Fluffster65/BattGuard/board/BattGuard/BattGuard.step

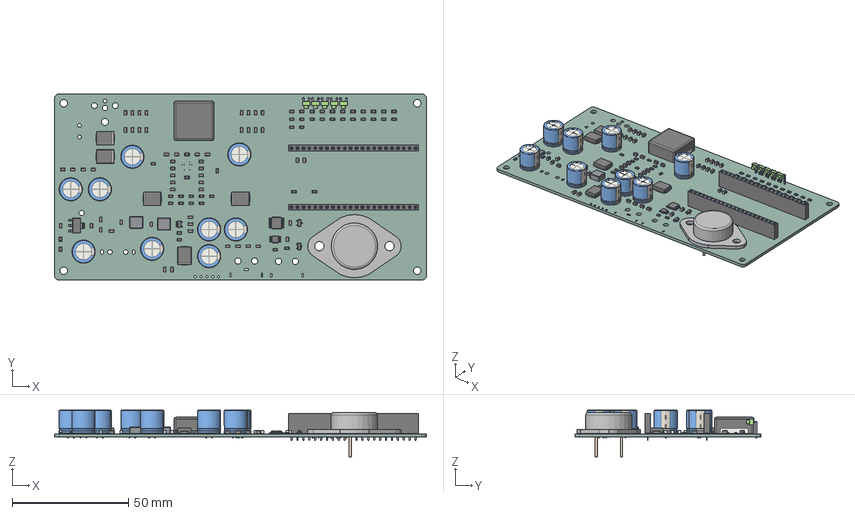
[picture p1: CAD file, 2026-10-19]
board/BattGuard/BattGuard.step
160.0 x 80.0 x 20.0 mm
PinSocket_1x22_P2.54mm_Vertical x 2
C_0805_2012Metric x 49
R_0805_2012Metric x 50
CP_Radial_D100mm_P250mm x 9
D_SMC x 5
TSSOP-10_3x3mm_P0.5mm
LED_D1.8mm_W1.8mm_H2.4mm_Horizontal_O1.27mm_Z4.9mm x 5
SOT-23 x 2
L_Bourns_SRP5030T x 2
SOT-23-5
SOT-223
L_Vishay_IHLP-6767
TSSOP-14_4.4x5mm_P0.65mm
TO-3
Bat6220_PCB
