Fluffster65/BattGuard/board/BattGuard/ESP32-Devboard.step

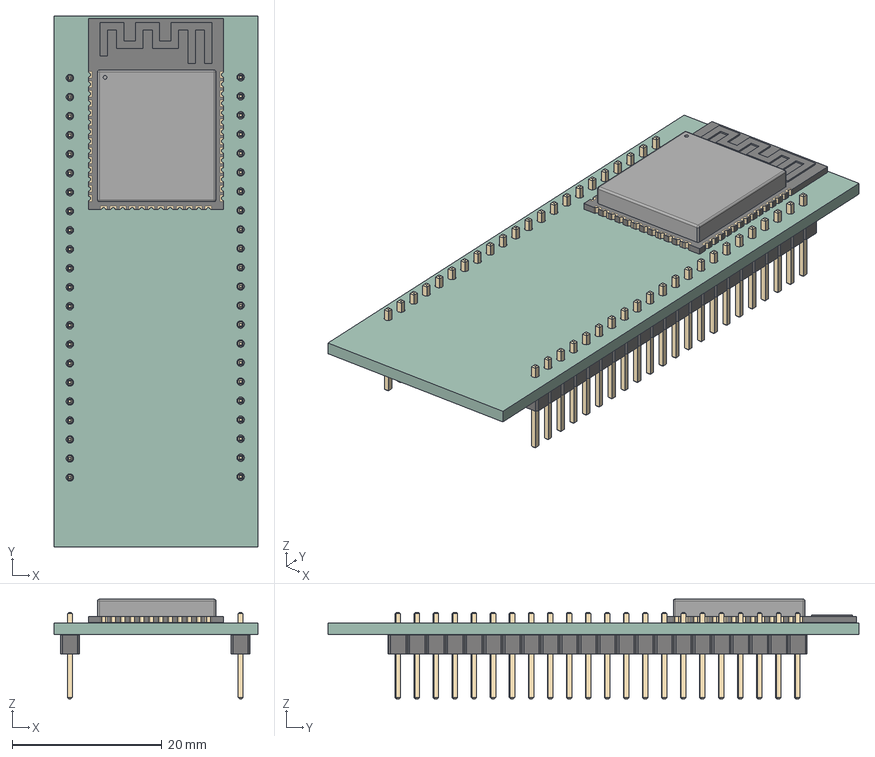
[picture p2: CAD file, 2026-10-19]
board/BattGuard/ESP32-Devboard.step
27.2 x 70.9 x 13.3 mm
ESP32-S3-WROOM-2
PinHeader_1x22_P254mm_Vertical x 2
ESPB6C6_PCB
