Fluffster65/BattGuard/board/BattGuard/BattGuard.kicad_pcb

## KiCad design board/BattGuard/BattGuard.kicad_pcb (2026-11-06)

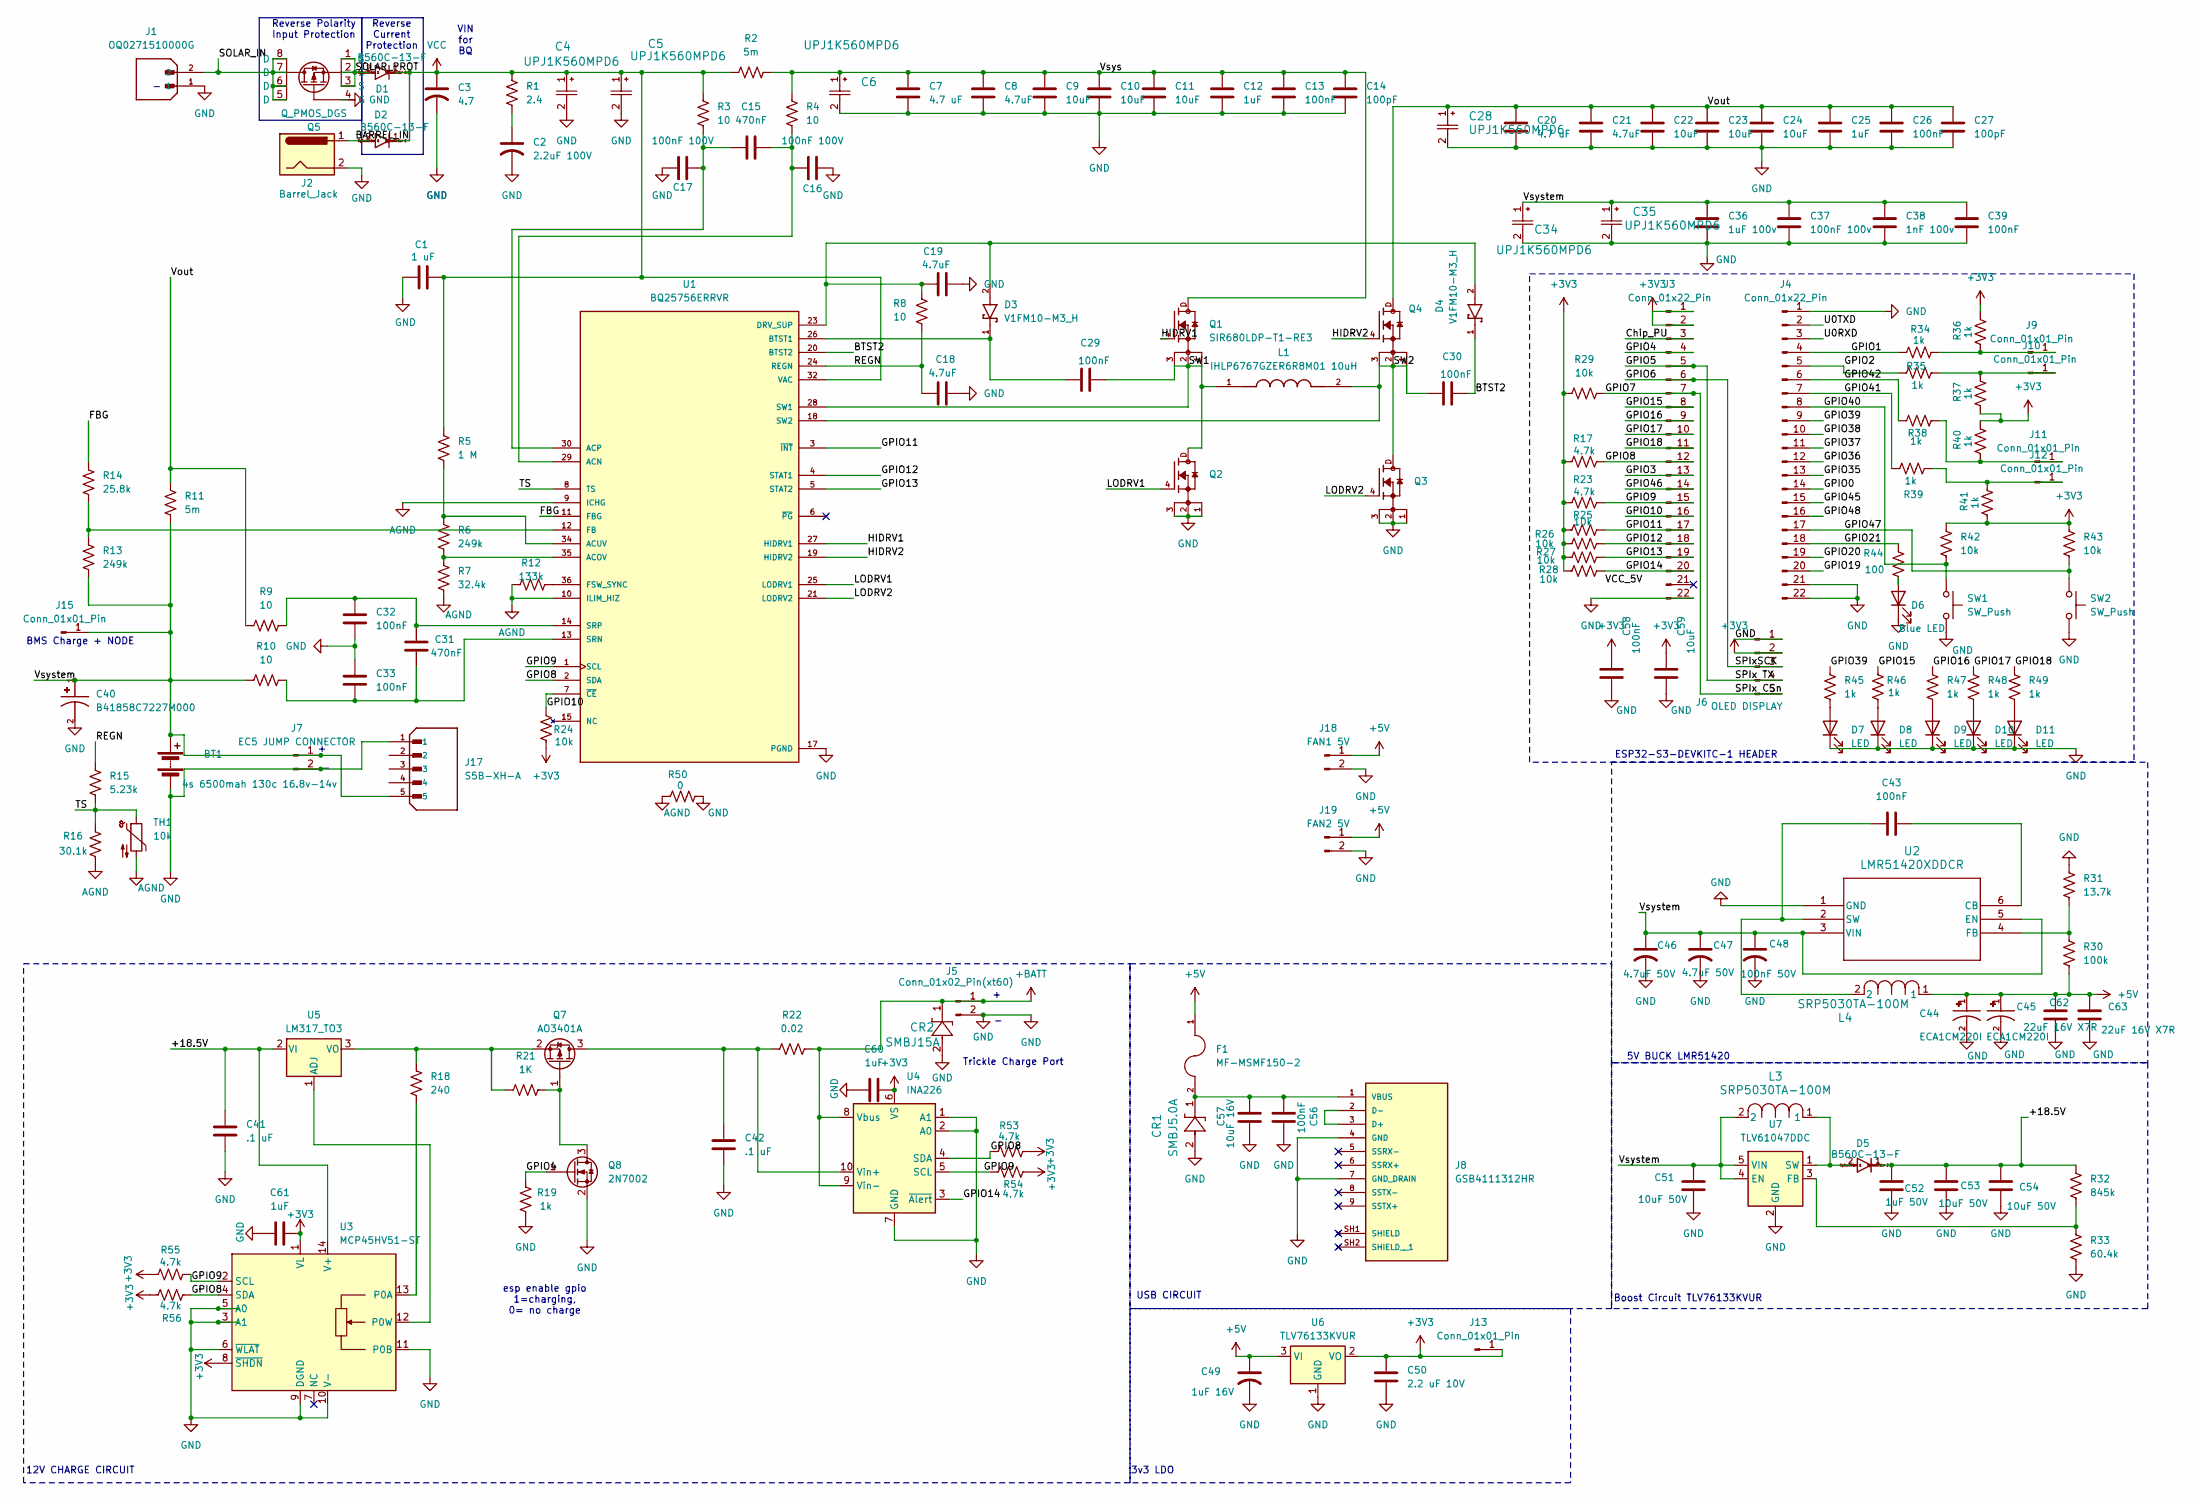
[picture p3: schematic BattGuard.kicad_sch]

Parts:
BT1: 4s 6500mah 130c 16.8v-14v
C1: 1 uF; C_0805_2012Metric
C2: 2.2uF 100V; C_1206_3216Metric
C3: 4.7; C_1210_3225Metric_Pad1.33x2.70mm_HandSolder
C4, C5, C6, C28, C34, C35: UPJ1K560MPD6; CAP_UPJ_10X15_NCH
C7, C20: 4.7 uF; C_0805_2012Metric
C8, C18, C19, C21: 4.7uF; C_0805_2012Metric
C9, C10, C11: 10uF; C_1210_3225Metric_Pad1.33x2.70mm_HandSolder
C12, C25, C60, C61: 1uF; C_0805_2012Metric
C13, C26, C29, C30, C32, C33, C39, C43, C56, C58: 100nF; C_0805_2012Metric
C14, C27: 100pF; C_0805_2012Metric
C15, C31: 470nF; C_0805_2012Metric
C16, C17: 100nF 100V; C_0805_2012Metric
C22, C23, C24, C59: 10uF; C_0805_2012Metric
C36: 1uF 100v; C_0805_2012Metric
C37: 100nF 100v; C_0805_2012Metric
C38: 1nF 100v; C_0805_2012Metric
C40: B41858C7227M000; CP_Radial_D10.0mm_P2.50mm; PARTREV 2018-10
C41, C42: .1 uF; C_0805_2012Metric
C44, C45: ECA1CM220I; CP_Radial_D10.0mm_P2.50mm; PARTREV 20-DEC-19
C46, C47: 4.7uF 50V; C_0805_2012Metric
C48: 100nF 50V; C_0805_2012Metric
C49: 1uF 16V; C_0805_2012Metric
C50: 2.2 uF 10V; C_0805_2012Metric
C51, C53, C54: 10uF 50V; C_1206_3216Metric_Pad1.33x1.80mm_HandSolder
C52: 1uF 50V; C_0805_2012Metric
C57: 10uF 16V; C_0805_2012Metric
C62, C63: 22uF 16V X7R; C_1206_3216Metric_Pad1.33x1.80mm_HandSolder
CR1: SMBJ5.0A; DO-214AASMB_J-BEND_LTF
CR2: SMBJ15A; DO-214AASMB_J-BEND_LTF
D1, D2, D5: B560C-13-F; D_SMC
D3, D4: V1FM10-M3_H; DIO_V1FM10-M3_H; PARTREV 13-May-2020; DigiKey_Part_Number 112-V1FM10-M3/HCT-ND
D6: Blue LED; LED_D1.8mm_W3.3mm_H2.4mm
D7, D8, D9, D10, D11: LED; LED_D1.8mm_W3.3mm_H2.4mm
F1: MF-MSMF150-2; FUSER_MF-MSMF150-2
J1: OQ0271510000G; PhoenixContact_GMSTBA_2,5_2-G_1x02_P7.50mm_Horizontal; PARTREV J
J2: Barrel_Jack; BarrelJack_CUI_PJ-063AH_Horizontal_CircularHoles
J3, J4: Conn_01x22_Pin; PinSocket_1x22_P2.54mm_Vertical
J5: Conn_01x02_Pin(xt60); AMASS_XT60PW-M_1x02_P7.20mm_Horizontal
J6: OLED DISPLAY; PinHeader_1x05_P2.54mm_Vertical
J7: EC5 JUMP CONNECTOR; AMASS_XT60PW-M_1x02_P7.20mm_Horizontal
J8: GSB4111312HR; USBA_receptacle; PARTREV B
J9, J10, J11, J12, J13: Conn_01x01_Pin; TestPoint_Pad_1.0x1.0mm
J15: Conn_01x01_Pin; MountingHole_2.2mm_M2_DIN965_Pad
J17: S5B-XH-A; JST_S5B-XH-A; PARTREV 27-1-20
J18: FAN1 5V; Wire_Pads_1x02_SMD_2.54
J19: FAN2 5V; Wire_Pads_1x02_SMD_2.54
L1: IHLP6767GZER6R8M01 10uH; L_Vishay_IHLP-6767; PARTREV 24-Nov-2023; DigiKey_Part_Number 541-1257-1-ND
L3, L4: SRP5030TA-100M; L_Bourns_SRP5030T
Q1, Q2, Q3, Q4: SIR680LDP-T1-RE3; TRANS_SIR680LDP-T1-RE3; PARTREV C
Q5: Q_PMOS_DGS; SOIC127P600X175-8N
Q7: AO3401A; SOT-23
Q8: 2N7002; SOT-23
R1: 2.4; R_0805_2012Metric
R2, R11: 5m; R_0805_2012Metric
R3, R4, R8, R9, R10: 10; R_0805_2012Metric
R5: 1 M; R_0805_2012Metric
R6, R13: 249k; R_0805_2012Metric
R7: 32.4k; R_0805_2012Metric
R12: 133k; R_0805_2012Metric
R14: 25.8k; R_0805_2012Metric
R15: 5.23k; R_0805_2012Metric
R16: 30.1k; R_0805_2012Metric
R17, R23, R53, R54, R55, R56: 4.7k; R_0805_2012Metric
R18: 240; R_0805_2012Metric
R19, R34, R35, R36, R37, R38, R39, R40, R41, R45, R46, R47, R48, R49: 1k; R_0805_2012Metric
R21: 1K; R_0805_2012Metric
R22: 0.02; R_0805_2012Metric
R24, R25, R26, R27, R28, R29, R42, R43: 10k; R_0805_2012Metric
R30: 100k; R_0805_2012Metric
R31: 13.7k; R_0805_2012Metric
R32: 845k; R_0805_2012Metric
R33: 60.4k; R_0805_2012Metric
R44: 100; R_0805_2012Metric
R50: 0; R_0805_2012Metric
SW1, SW2: SW_Push; Wire_Pads_1x02_SMD_2.54
TH1: 10k; R_0805_2012Metric
U1: BQ25756ERRVR; IC_BQ25756ERRVR; PARTREV November 2023; DigiKey_Part_Number 296-BQ25756ERRVRCT-ND
U2: LMR51420XDDCR; SOT23_DDC_TEX
U3: MCP45HV51-ST; TSSOP-14_4.4x5mm_P0.65mm
U4: INA226; TSSOP-10_3x3mm_P0.5mm
U5: LM317_TO3; TO-3
U6: TLV76133KVUR; SOT-223-3_TabPin2
U7: TLV61047DDC; SOT-23-5

Connections:
+5V: C44.1, C45.1, C49.1, C62.1, C63.1, F1.1, J18.1, J19.1, L4.1, R30.2, U6.3 (VI); also elsewhere on the board
+BATT: CR2.1, J5.1, R22.2, U4.8 (Vbus), U4.9 (Vin-)
/+18.5V: C41.1, C52.1, C53.1, C54.1, D5.1, R32.1, U3.14 (V+), U5.2 (VI); also elsewhere on the board
/BARREL_IN: D2.2, J2.1
/BTST2: C30.2, D4.1, U1.20 (BTST2)
/Chip_PU: J3.3
/FBG: R14.1, U1.11 (FBG)
/GPIO0: J4.14
/GPIO1: J4.4, R34.1
/GPIO2: J4.5, R35.1
/GPIO3: J3.13
/GPIO4: J3.4, Q8.1 (G), R19.2
/GPIO5: J3.5, J6.4
/GPIO6: J3.6, J6.3
/GPIO7: J3.7, J6.5, R29.2
/GPIO8: J3.12, R17.2, R53.2, R56.1, U1.2 (SDA), U3.4 (SDA), U4.4 (SDA)
/GPIO9: J3.15, R23.2, R54.2, R55.1, U1.1 (SCL), U3.2 (SCL), U4.5 (SCL)
/GPIO10: J3.16, R24.2, U1.7 (~CE)
/GPIO11: J3.17, R25.2, U1.3 (~INT)
/GPIO12: J3.18, R26.2, U1.4 (STAT1)
/GPIO13: J3.19, R27.2, U1.5 (STAT2)
/GPIO14: J3.20, R28.2, U4.3 (~Alert)
/GPIO15: J3.8, R46.1
/GPIO16: J3.9, R47.1
/GPIO17: J3.10, R48.1
/GPIO18: J3.11, R49.1
/GPIO19: J4.20
/GPIO20: J4.19
/GPIO21: J4.18, R44.1
/GPIO35: J4.13
/GPIO36: J4.12
/GPIO37: J4.11
/GPIO38: J4.10
/GPIO39: J4.9, R45.1
/GPIO40: J4.8, R42.2, SW1.1
/GPIO41: J4.7, R39.1
/GPIO42: J4.6, R38.1
/GPIO45: J4.15
/GPIO46: J3.14
/GPIO47: J4.17, R43.2, SW2.1
/GPIO48: J4.16
/HIDRV1: Q1.4, U1.27 (HIDRV1)
/HIDRV2: Q4.4, U1.19 (HIDRV2)
/LODRV1: Q2.4, U1.25 (LODRV1)
/LODRV2: Q3.4, U1.21 (LODRV2)
/REGN: C18.1, R8.1, R15.1, U1.24 (REGN)
/SOLAR_IN: J1.2, Q5.5 (D), Q5.6 (D), Q5.7 (D), Q5.8 (D)
/SOLAR_PROT: D1.2, Q5.1 (S), Q5.2 (S), Q5.3 (S)
/SW1: C29.2, L1.1, Q1.1, Q1.2, Q1.3, Q2.D, U1.28 (SW1)
/SW2: C30.1, L1.2, Q3.D, Q4.1, Q4.2, Q4.3, U1.18 (SW2)
/TS: R15.2, R16.1, TH1.1, U1.8 (TS); also elsewhere on the board
/U0RXD: J4.3
/U0TXD: J4.2
/Vout: C20.1, C21.1, C22.1, C23.1, C24.1, C25.1, C26.1, C27.1, C28.1, Q4.D, R9.1, R11.1
/Vsys: C6.1, C7.1, C8.1, C9.1, C10.1, C11.1, C12.1, C13.1, C14.1, Q1.D, R2.2, R4.1
/Vsystem: BT1.1 (+), C34.1, C35.1, C36.1, C37.1, C38.1, C39.1, C40.1, C46.1, C47.1, C48.1, C51.1, J7.1, J15.1 (Pin_1_1), J17.5, L3.2, R10.1, R11.2, R13.2, U2.3 (VIN), U2.5 (EN), U7.4 (EN), U7.5 (VIN)
AGND: R7.2, R12.1, R16.2, R50.1, TH1.2, U1.9 (ICHG), U1.10 (ILIM_HIZ); also elsewhere on the board
GND: BT1.2 (-), C1.1, C2.2, C3.2, C4.2, C5.2, C6.2, C7.2, C8.2, C9.2, C10.2, C11.2, C12.2, C13.2, C14.2, C16.2, C17.1, C18.2, C19.2, C20.2, C21.2, C22.2, C23.2, C24.2, C25.2, C26.2, C27.2, C28.2, C32.1, C33.2, C34.2, C35.2, C36.2, C37.2, C38.2, C39.2, C40.2, C41.2, C42.2, C44.2, C45.2, C46.2, C47.2, C48.2, C49.2, C50.2, C51.2, C52.2, C53.2, C54.2, C56.2, C57.2, C58.2, C59.2, C60.1, C61.1, C62.2, C63.2, CR1.2, CR2.2, D6.1 (K), D7.1 (K), D8.1 (K), D9.1 (K), D10.1 (K), D11.1 (K), J1.1, J2.2, J3.22, J4.1, J4.21, J4.22, J5.2, J6.1, J7.2, J8.4 (GND), J8.7 (GND_DRAIN), J17.1, J18.2, J19.2, Q2.1, Q2.2, Q2.3, Q3.1, Q3.2, Q3.3, Q5.4 (G), Q8.2 (S), R19.1, R31.1, R33.2, R50.2, SW1.2, SW2.2, U1.17 (PGND), U1.22 (PGND), U1.37 (PGND), U2.1 (GND), U3.3 (A1), U3.5 (A0), U3.6 (~WLAT), U3.9 (DGND), U3.10 (V-), U3.11 (P0B), U4.1 (A1), U4.2 (A0), U4.7 (GND), U6.1 (GND), U7.2 (GND); also elsewhere on the board
unnamed: C2.1, R1.2
unnamed: D6.2 (A), R44.2
unnamed: D7.2 (A), R45.2
unnamed: D8.2 (A), R46.2
unnamed: D9.2 (A), R47.2
unnamed: D10.2 (A), R48.2
unnamed: D11.2 (A), R49.2
unnamed: J8.2 (D-), J8.3 (D+)
unnamed: C56.1, C57.1, CR1.1, F1.2, J8.1 (VBUS)
unnamed: J10.1 (Pin_1_1), R35.2, R37.2
unnamed: J11.1 (Pin_1_1), R38.2, R40.1
unnamed: J12.1 (Pin_1_1), R39.2, R41.2
unnamed: C42.1, Q7.3 (D), R22.1, U4.10 (Vin+)
unnamed: Q7.1 (G), Q8.3 (D), R21.2
unnamed: Q7.2 (S), R18.1, R21.1, U5.3 (VO)
unnamed: C15.2, C16.1, R4.2, U1.29 (ACN)
unnamed: R6.2, R7.1, U1.35 (ACOV)
unnamed: C15.1, C17.2, R3.2, U1.30 (ACP)
unnamed: R5.2, R6.1, U1.34 (ACUV)
unnamed: C29.1, D3.1, U1.26 (BTST1)
unnamed: C19.1, D3.2, D4.2, R8.2, U1.23 (DRV_SUP)
unnamed: R13.1, R14.2, U1.12 (FB)
unnamed: R12.2, U1.36 (FSW_SYNC)
unnamed: C31.1, C33.1, R10.2, U1.13 (SRN)
unnamed: C31.2, C32.2, R9.2, U1.14 (SRP)
unnamed: C43.2, U2.6 (CB)
unnamed: R30.1, R31.2, U2.4 (FB)
unnamed: C43.1, L4.2, U2.2 (SW)
unnamed: R18.2, U3.13 (P0A)
unnamed: U3.12 (P0W), U5.1 (ADJ)
unnamed: R32.2, R33.1, U7.3 (FB)
unnamed: D5.2, L3.1, U7.1 (SW)
VCC: C1.2, C3.1, C4.1, C5.1, D1.1, D2.1, R1.1, R2.1, R3.1, R5.1, U1.32 (VAC), U1.33 (VAC)

Notes on the sheet:
Reverse Current Protection
Boost Circuit TLV76133KVUR
Trickle Charge Port
3v3 LDO
GND
12V CHARGE CIRCUIT
BMS Charge + NODE
ESP32-S3-DEVKITC-1 HEADER
5V BUCK LMR51420
USB CIRCUIT
VIN for BQ
esp enable gpio 1=charging, 0= no charge
Reverse Polarity Input Protection

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
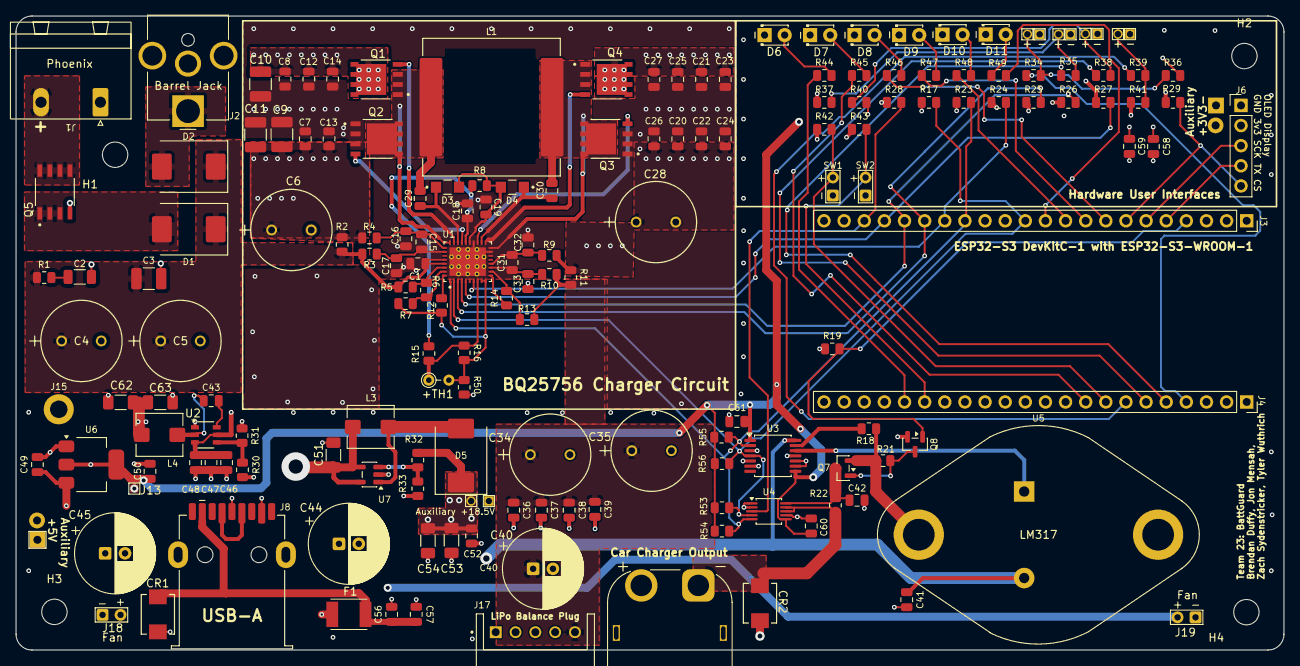
[picture p4: board BattGuard.kicad_pcb from above]

Board: 4 copper layers, 160.0 x 80.0 mm, 179 parts (0 on the bottom side), 79 nets.

Other parts of the board:
+TH1: 10k; R_Axial_DIN0204_L3.6mm_D1.6mm_P2.54mm_Vertical
GND: Conn_01x01_Pin; GND_Pin_1.0x1.0mm
GND#2, GND#3, GND#4, GND#5, GND#6, GND#7: Conn_01x01_Pin; GND_Pin_1.0x1.0mm
H1, H2, H3, H4: MountingHole_3.2mm_M3
J9#2, J9#3, J9#4: Conn_01x01_Pin; TestPoint_Pad_1.0x1.0mm

Their connections:
+5V: J9#4.1 (Pin_1_1); also elsewhere on the board
/+18.5V: J9#2.1 (Pin_1_1); also elsewhere on the board
/TS: +TH1.1; also elsewhere on the board
AGND: +TH1.2; also elsewhere on the board
GND: GND.1 (Pin_1_1), GND#2.1 (Pin_1_1), GND#3.1 (Pin_1_1), GND#4.1 (Pin_1_1), GND#5.1 (Pin_1_1), GND#6.1 (Pin_1_1), GND#7.1 (Pin_1_1); also elsewhere on the board
