Fluffster65/BattGuard/(commit log)

2026-09-23 Set up shared KiCad project and team library structure
2026-09-23 Address review thread on KiCad placeholders
2026-10-13 schematic imports
2026-10-14 Add KiCad v10 libs and new board symbols
    Add local KiCad footprint/symbol library tables for the BattGuard board and register TeamLib via project environment paths. Regenerate the BQ25756ERRVR footprint in KiCad 10 format, expand TeamLib symbols with BQ25756ERRVR and SC1176 definitions, and add a dedicated ESP32-S3-WROOM-1 symbol library file.
2026-10-14 Add ESP32 KiCad project and update settings
    Import ESP32 devboard gerber file into .pcb file.
    Add a new `ESP32-Devboard.kicad_pro` KiCad project file with default board and net settings. Update `BattGuard.kicad_pro` to include full board design/DRC/ERC configuration and register `BattGuard.kicad_sch` as the top-level schematic sheet, aligning the project metadata with current KiCad defaults.
2026-10-19 10.18.2026 Schematic v1
2026-10-19 10.19.2026 pcb layout
2026-10-19 10.19.2026 pcb v1 no route
2026-10-19 ESP32 Devboard Update
    STEP File and PCB Update
2026-10-20 Updated ESP32 Devkit, Added Input protection
    Reverse polarity BQ Input protection, labeled input blocks, added model for U2
2026-10-20 10.20.2026 Changes
    Fixed connectors, pours, some NCs
2026-10-29 10.29.2026
    fixed copper keepouts around all 4 mounting holes so the screws can’t short to the frame.
    Removed J7 from the board,
    Added fan pads J18 and J19
    fixed polarized symbols
    Changed C2 to 2.2 µF, 100 V, 1206.
    BQ25756 Shifted according to checklist
    Gave D3/D4 their correct small footprint.
    Connected U1’s thermal vias to GND.
    Re-routed the BQ area to the TI checklist:
    HIDRV is 0.5 mm, paired with its SW trace.
    LODRV runs on the bottom layer.
    Fixed input nodes solar in, then solar_Prot(reverse protected node), and barrel in all to VCC node
2026-10-29 ESD Protection Diodes + 60V 6.6A PMOS RV Prot
    Updated schematic and layout to include 15V and 5V ESD protection diodes to the charge output. Also replaced undersized PMOS for solar reverse voltage input with 8-pin DIP DGS PMOSFET.
2026-10-29 10.29.2026
    Fixed pad connections around BQ, moved Thermisistor pads and setup vias for wires, keepout for inductor, placed oled header connector,
2026-10-30 10.29.2026 Night
    Routed ALL GPIO Traces from bq and other perhpirals, moved fan pads to oppsite sides of boards, fixed LED pads,
2026-10-30 5V Reg, 18V Boost, Parts of the LM317 Circuit
    - Finished 5V Reg placement and routing, and distributed VSystem for other components.
    - Finished 18V boost circuit layout and prepped it for distribution throughout the board
    - Reorganized some of the High-side switch for ease of access and minimizing long traces.
    - Trace routing to minimize bends, added teardrops throughout PCB to make unevenly sized traces align with mounting pads and vias.
2026-10-30 Routed more traces around the MOSFET switch
    Upsized traces etc.
2026-10-30 10.30.2026 New Cap footprints
2026-10-30 10.30.2026 updated
    updated capicator footprints, cleaned up and routed 12v charge circuit section, updated clearance rules for pad clearnce issues.
2026-10-30 10.30.2026 fixed capictor routing, 18.5 feed line setup correctly 12v charge circuit done and cleaned up
2026-10-31 10.30.2026 rev 1
    all traces routed, time to go through shivams checklist
2026-10-31 Trace Cleaning/Straigtening SilkScreen Placement and Sizing
    Throughout most of the board trace routing has been straightened out where possible. Silkscreen that overlapped in tight areas were resized, and most IC silkscreens labels were moved to nearby its Pin 1.
2026-10-31 Finished DRC errors
    Many Fill zones which had conflicting intersections replaced with unified zones that cover their full area to avoid conflicts. Many vias of 0.6mm and 0.4mm hole were causing an error, and were replaced with 0.3mm hole to solve the problem. Several courtyard conflicts were resolved, unconnected GND pins were grounded.
2026-10-31 Continue Addressing DRC Warnings`
    silkscreen placement, Copper fill islands, etc. Started filling in different footprints for Caps that Zach mentioned were in stock to meet the capacitance specs.
2026-11-01 Added I2C optional Pull-up Resistors + Bulk Caps to Vs
    Populated I2C pullup resistor pairs for SDA and SCL for digi-pot and INA226. Then populated capacitors for their power lines to prevent brown-out. Corrected 3v3 to ground short from R26 3v3 to R24 GND. Continued improving trace routing and addressing several DRC warnings (overlapping silk screen, Copper fill islands, etc.)
2026-11-02 11.1.2026
    Fixed bq CE pin, now pulls up to 3v3 for esp configuration.
2026-11-02 Shunt Placement INA layout Improvement
    Rerouting Shunt R22 to be proximally closer to INA226 for current measurement. Rerouting V supply bypass cap to be proximally closer supply and gnd pins of INA226. Minor trace routing, silk screen, and isolated pour fixes. 75 DRC warnings left, and 0 Errors
2026-11-02 11.2.2026
    oled gpio trace fixes, ina 226 trace fixes,
2026-11-03 Extensive bug fixing and Warning Corrections
    Footprints for all errant symbols were addressed. Numerous trace paths were straightened and shortened to make better routes and minimize vias between layers.
    Larger capacitor footprints were loaded meet the requests of the packages Zach found on Digikey.
2026-11-04 Test Points, Buttons, Switches Routing
    All LEDs, button wire solder points, and switch-wire solder point footprints were updated or created. Traces were rerouted to accommodate numerous through-hole components.
    5 hours spent, 0 DRC errors, 3 warnings
2026-11-04 Cap placement and 18.5V Trace Width
    Updated, based on Xiang's Feedback
2026-11-04 Expand README for current BattGuard project status
2026-11-04 Pads -> TH, Model Updating, Vias -> TH
    Updated Models and footprints for all components that weren't populating correctly, Added TH mounting holes for Fans, Replaced GND Vias for GPIO buttons and switches with plated THs.
2026-11-05 Updated TH1 footprint to TH
    Gave the TH resistor pads for the thermistor leads to go out from. Plus some minor trace routing improvements in the neighborhood. Also, a backup folder was created when I booted from my desktop, so I'm committing it too.
2026-11-05 Addressed Issues raised by Staff
    Trace sizing, via sizing, Back-up plug-in ports for external DC input in case the regulators don't work. Stitching vias for an isolated ground plane. Layout for the 5V regulator should almost 1:1 mirror the TI recommended spec (needs revisions).
2026-11-05 Added Auxiliary 3v3, 5V, 18.5V Plated Through Holes
    Need to verify that the ESP32 devboard has none of its output power pins connected to the PCB to avoid shorting the supplies.
2026-11-06 11.6.2026
    Modifed LMR51420 5v Buck layout according to datasheet per walters instructions. DRC errors fixed, now 0.
2026-11-06 Labeling Silkscreen
    Final round through the board to add silkscreen to label many of the zones, ensure uncovered silkscreen when parts are populated, and labeling off-board button and connector points i.e. auxiliary voltage inputs.
